malvira/slink/README.md

Slink
=====

Possible alternative for AO fet is IRLR3636TRPBFCT-ND
