malvira/slink/(commit log)

2011-04-11 Good first cut at the full design: still need to decide how many LEDs and how many strings there are per board.
    [led-data.csv]
2011-04-11 added some example LED config options.
2011-04-12 empty pcb files
    [slink.brd, slink.sch]
2011-04-12 Design doc and led data
    [led-data.csv]
2011-04-12 Added basic LED package and board package
2011-04-12 progress adding parts
    [slink.brd, slink.sch]
2011-04-12 notes about number of LEDs/strings/and how many to pair up.
2011-04-12 finish formfactor and LED devices.
    Add 96 leds with ground polygon to slink{.brd,.sch}
    [slink.brd, slink.sch]
2011-04-12 most of the parts are here. Added a few notes.
    About ready to integrate on final board.
    [sch-sections.brd, sch-sections.sch]
2011-04-12 added 6 FET stages and the bus bars.
    [slink.brd, slink.sch]
2011-04-13 laid out leds, modified board size etc... need to move pads for wider traces
    [slink.brd, slink.sch]
2011-04-13 everything placed. Should be ready to route.
    [slink.brd, slink.sch]
2011-04-13 wired the LED chains
    [slink.brd, slink.sch]
2011-04-14 routed almost everything except fuse-related structures...
    [slink.brd]
2011-04-14 final fuse plan
2011-04-14 finished all routing except controller connections, VLED, GND-GND, and 12V0
    [slink.brd, slink.sch]
2011-04-15 routing complete. ready for silk.
    [slink.brd, slink.sch]
2011-04-15 4pcb silk done
    [slink.brd, slink.sch]
2011-04-15 added panel
    [panel.brd]
2011-04-15 added gerbers
2011-04-20 add top paste gerber without dimension for a single board to order stencil
    [slink-r1-toppaste.gtp]
2011-04-21 update design document with star connected power and inline fuses
    also update status and todo items
2011-04-21 ignore .cad
2011-04-21 add bom with digikey numbers
    [slink.csv]
2011-05-13 update BOM.
    [slink.csv]
2011-05-20 current vs voltage data.
    [current-voltage.csv]
